theta-machines/DEV-G2-NANO/kicad/DEV-G2-NANO.kicad_pcb

## KiCad design kicad/DEV-G2-NANO.kicad_pcb (2026-06-29)

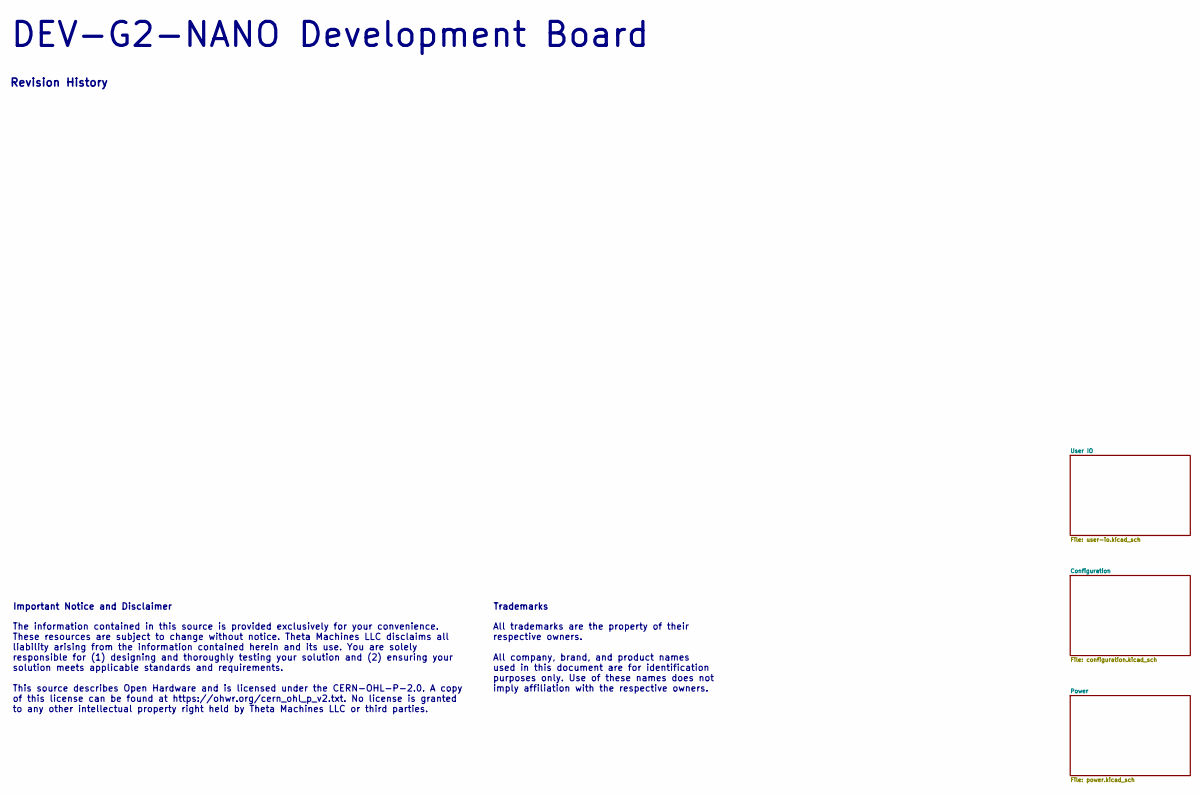
[picture p2: schematic DEV-G2-NANO.kicad_sch]

Notes on the sheet:
Revision History
DEV-G2-NANO Development Board
Important Notice and Disclaimer
Trademarks
The information contained in this source is provided exclusively for your convenience. These resources are subject to change without notice. Theta Machines LLC disclaims all liability arising from the information contained herein and its use. You are solely responsible for (1) designing and thoroug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
All trademarks are the property of their respective owners. All company, brand, and product names used in this document are for identification purposes only. Use of these names does not imply affiliation with the respective owners.

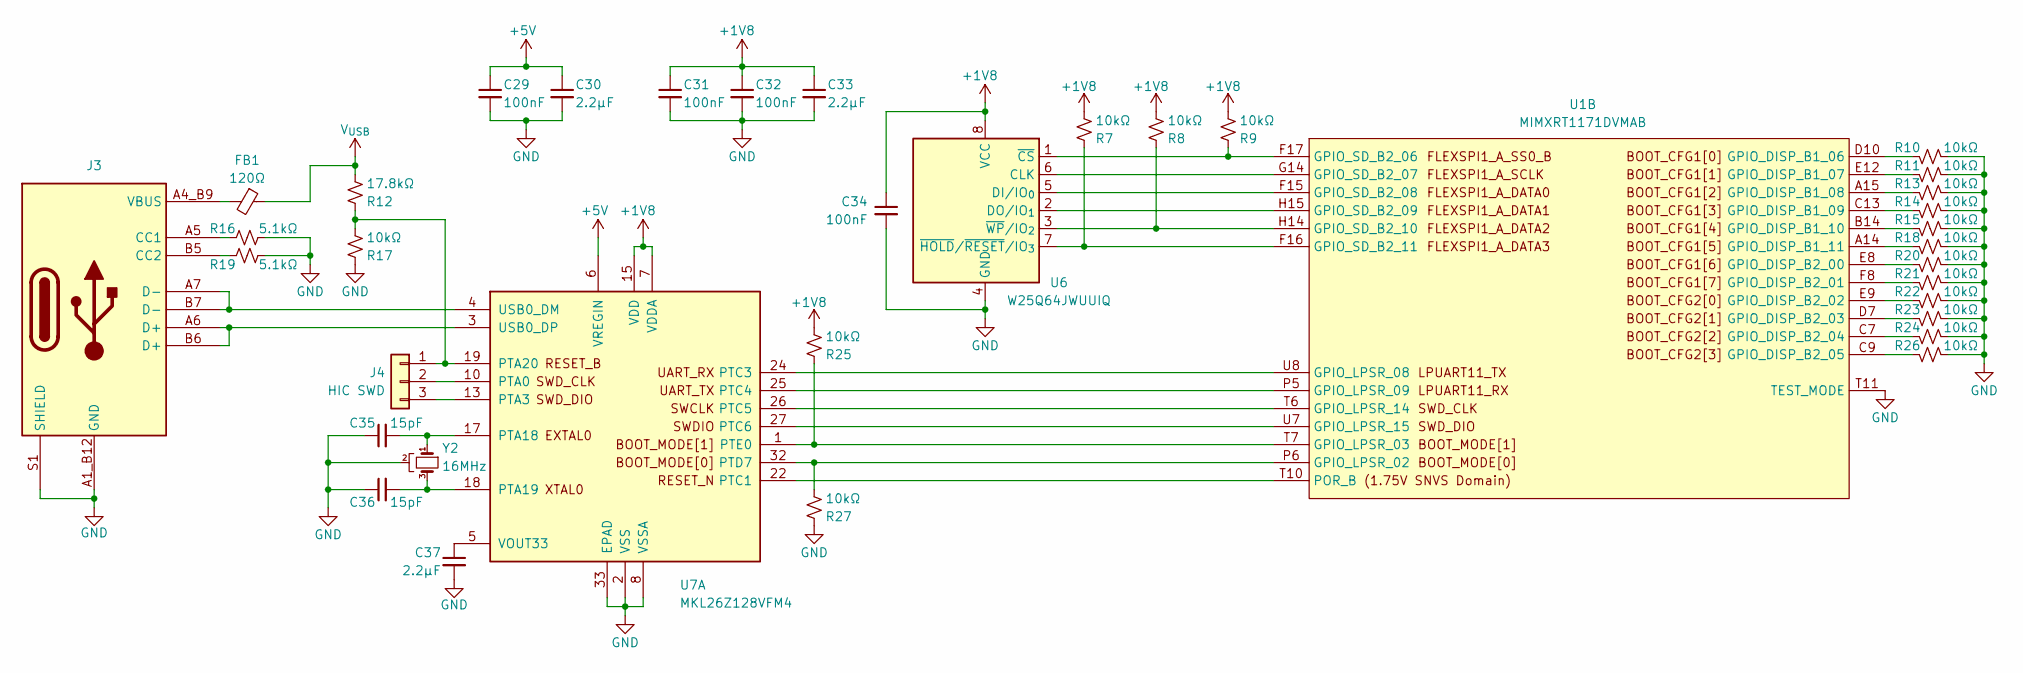
[picture p3: schematic configuration.kicad_sch, DEV-G2-NANO]

Parts:
C29, C31, C32, C34: 100nF; C_0201_0603Metric
C30, C33, C37: 2.2μF; C_0201_0603Metric
C35, C36: 15pF; C_0402_1005Metric
FB1: 120Ω; L_0402_1005Metric
J3: USB C; UJ20-C-H-G-SMT-5-P16
J4: HIC SWD; TestPoints-3
R7, R8, R9, R10, R11, R13, R14, R15, R17, R18, R20, R21, R22, R23, R24, R25, R26, R27: 10kΩ; R_0201_0603Metric
R12: 17.8kΩ; R_0201_0603Metric
R16, R19: 5.1kΩ; R_0201_0603Metric
U1: MIMXRT1171DVMAB
U6: W25Q64JWUUIQ
U7: MKL26Z128VFM4
Y2: 16MHz; Crystal-4-Pin

Connections:
+1V8: C31.1, C32.1, C33.1, C34.1, R7.2, R8.2, R9.2, R25.2, U6.8 (VCC), U7.7 (VDDA), U7.15 (VDD); also elsewhere on the board
+5V: C29.1, C30.1, U7.6 (VREGIN); also elsewhere on the board
GND: C29.2, C30.2, C31.2, C32.2, C33.2, C34.2, C35.1, C36.1, C37.2, J3.A1_B12 (GND), J3.B1_A12 (GND), J3.S1 (SHIELD), R10.2, R11.2, R13.2, R14.2, R15.2, R16.2, R17.1, R18.2, R19.2, R20.2, R21.2, R22.2, R23.2, R24.2, R26.2, R27.1, U1.T11 (TEST_MODE), U6.4 (GND), U7.2 (VSS), U7.8 (VSSA), U7.16 (VSS), U7.33 (EPAD), Y2.2 (GND), Y2.4 (GND); also elsewhere on the board
unnamed: FB1.2, J3.A4_B9 (VBUS), J3.B4_A9 (VBUS)
unnamed: J3.A5 (CC1), R16.1
unnamed: J3.B5 (CC2), R19.1
unnamed: J4.1, R12.1, R17.2, U7.19 (PTA20)
unnamed: J4.2, U7.10 (PTA0)
unnamed: J4.3, U7.13 (PTA3)
unnamed: R10.1, U1.D10 (GPIO_DISP_B1_06)
unnamed: R11.1, U1.E12 (GPIO_DISP_B1_07)
unnamed: R13.1, U1.A15 (GPIO_DISP_B1_08)
unnamed: R14.1, U1.C13 (GPIO_DISP_B1_09)
unnamed: R15.1, U1.B14 (GPIO_DISP_B1_10)
unnamed: R18.1, U1.A14 (GPIO_DISP_B1_11)
unnamed: R20.1, U1.E8 (GPIO_DISP_B2_00)
unnamed: R21.1, U1.F8 (GPIO_DISP_B2_01)
unnamed: R22.1, U1.E9 (GPIO_DISP_B2_02)
unnamed: R23.1, U1.D7 (GPIO_DISP_B2_03)
unnamed: R24.1, U1.C7 (GPIO_DISP_B2_04)
unnamed: R26.1, U1.C9 (GPIO_DISP_B2_05)
unnamed: R27.2, U1.P6 (GPIO_LPSR_02), U7.32 (PTD7)
unnamed: R25.1, U1.T7 (GPIO_LPSR_03), U7.1 (PTE0)
unnamed: U1.U8 (GPIO_LPSR_08), U7.24 (PTC3)
unnamed: U1.P5 (GPIO_LPSR_09), U7.25 (PTC4)
unnamed: U1.T6 (GPIO_LPSR_14), U7.26 (PTC5)
unnamed: U1.U7 (GPIO_LPSR_15), U7.27 (PTC6)
unnamed: R9.1, U1.F17 (GPIO_SD_B2_06), U6.1 (~CS)
unnamed: U1.G14 (GPIO_SD_B2_07), U6.6 (CLK)
unnamed: U1.F15 (GPIO_SD_B2_08), U6.5 (DI/IO_{0})
unnamed: U1.H15 (GPIO_SD_B2_09), U6.2 (DO/IO_{1})
unnamed: R8.1, U1.H14 (GPIO_SD_B2_10), U6.3 (~WP/IO_{2})
unnamed: R7.1, U1.F16 (GPIO_SD_B2_11), U6.7 (~HOLD/~RESET/IO_{3})
unnamed: U1.T10 (POR_B), U7.22 (PTC1)
unnamed: C35.2, U7.17 (PTA18), Y2.1
unnamed: C36.2, U7.18 (PTA19), Y2.3
unnamed: J3.A7 (D-), J3.B7 (D-), U7.4 (USB0_DM)
unnamed: J3.A6 (D+), J3.B6 (D+), U7.3 (USB0_DP)
unnamed: C37.1, U7.5 (VOUT33)
V_{USB}: FB1.1, R12.2; also elsewhere on the board

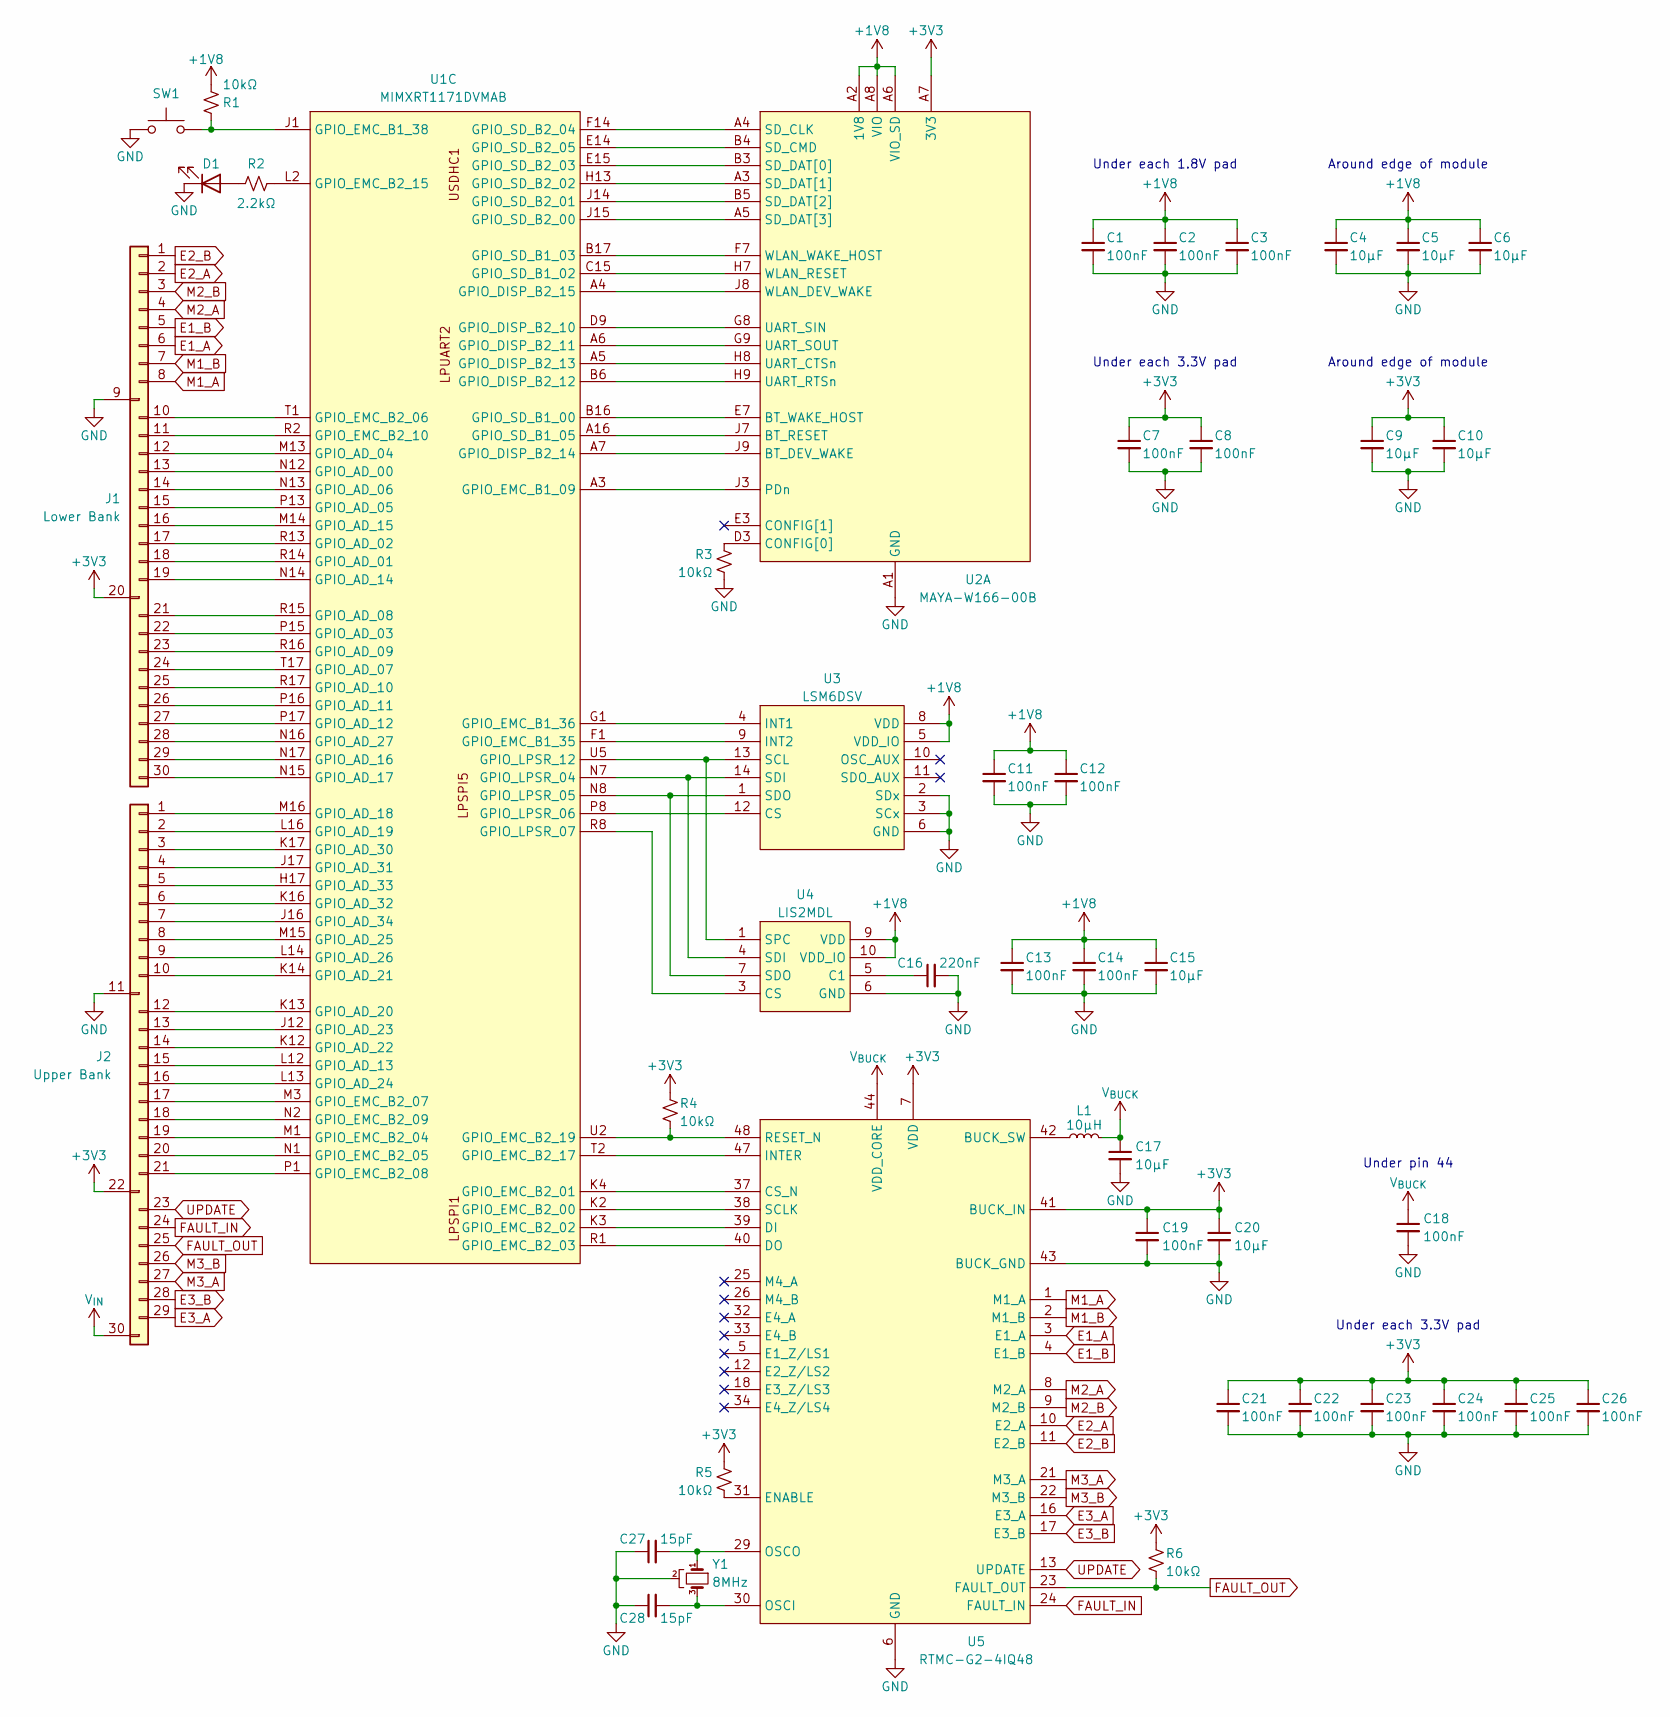
[picture p4: schematic user-io.kicad_sch, DEV-G2-NANO]

Parts:
C1, C2, C3, C7, C8, C11, C12, C13, C14, C18, C19, C21, C22, C23, C24, C25, C26: 100nF; C_0201_0603Metric
C4, C5, C6, C9, C10, C15, C17, C20: 10μF; C_0402_1005Metric
C16: 220nF; C_0201_0603Metric
C27, C28: 15pF; C_0402_1005Metric
D1: RED; LED_0603_1608Metric
J1: Lower Bank; Header-1x30
J2: Upper Bank; Header-1x30
L1: 10μH; L_1008_2520Metric
R1, R3, R4, R5, R6: 10kΩ; R_0201_0603Metric
R2: 2.2kΩ; R_0201_0603Metric
SW1: PTS815
U1: MIMXRT1171DVMAB
U2: MAYA-W166-00B
U3: LSM6DSV
U4: LIS2MDL
U5: RTMC-G2-4IQ48
Y1: 8MHz; Crystal-4-Pin

Connections:
+1V8: C1.1, C2.1, C3.1, C4.1, C5.1, C6.1, C11.1, C12.1, C13.1, C14.1, C15.1, R1.2, U2.A2 (1V8), U2.A6 (VIO_SD), U2.A8 (VIO), U3.5 (VDD_IO), U3.8 (VDD), U4.9 (VDD), U4.10 (VDD_IO); also elsewhere on the board
+3V3: C7.1, C8.1, C9.1, C10.1, C19.1, C20.1, C21.1, C22.1, C23.1, C24.1, C25.1, C26.1, J1.20, J2.22, R4.1, R5.1, R6.1, U2.A7 (3V3), U2.B7 (3V3), U5.7 (VDD), U5.15 (VDD), U5.20 (VDD), U5.28 (VDD), U5.36 (VDD), U5.41 (BUCK_IN), U5.46 (VDD); also elsewhere on the board
E1_A: J1.6, U5.3 (E1_A)
E1_B: J1.5, U5.4 (E1_B)
E2_A: J1.2, U5.10 (E2_A)
E2_B: J1.1, U5.11 (E2_B)
E3_A: J2.29, U5.16 (E3_A)
E3_B: J2.28, U5.17 (E3_B)
FAULT_IN: J2.24, U5.24 (FAULT_IN)
FAULT_OUT: J2.25, R6.2, U5.23 (FAULT_OUT)
GND: C1.2, C2.2, C3.2, C4.2, C5.2, C6.2, C7.2, C8.2, C9.2, C10.2, C11.2, C12.2, C13.2, C14.2, C15.2, C16.2, C17.2, C18.2, C19.2, C20.2, C21.2, C22.2, C23.2, C24.2, C25.2, C26.2, C27.1, C28.1, D1.1 (K), J1.9, J2.11, R3.2, SW1.1, U2.A1 (GND), U2.A9 (GND), U2.B2 (GND), U2.B8 (GND), U2.E4 (GND), U2.E5 (GND), U2.F4 (GND), U2.F5 (GND), U2.H4 (GND), U2.H5 (GND), U2.K2 (GND), U2.K3 (GND), U2.K4 (GND), U2.K6 (GND), U2.K7 (GND), U2.K8 (GND), U2.L1 (GND), U2.L9 (GND), U2.M1 (GND), U2.M2 (GND), U2.M8 (GND), U2.M9 (GND), U3.2 (SDx), U3.3 (SCx), U3.6 (GND), U3.7 (GND), U4.6 (GND), U4.8 (GND), U5.6 (GND), U5.14 (GND), U5.19 (GND), U5.27 (GND), U5.35 (GND), U5.43 (BUCK_GND), U5.45 (GND), Y1.2 (GND), Y1.4 (GND); also elsewhere on the board
M1_A: J1.8, U5.1 (M1_A)
M1_B: J1.7, U5.2 (M1_B)
M2_A: J1.4, U5.8 (M2_A)
M2_B: J1.3, U5.9 (M2_B)
M3_A: J2.27, U5.21 (M3_A)
M3_B: J2.26, U5.22 (M3_B)
unnamed: D1.2 (A), R2.1
unnamed: J1.10, U1.T1 (GPIO_EMC_B2_06)
unnamed: J1.11, U1.R2 (GPIO_EMC_B2_10)
unnamed: J1.12, U1.M13 (GPIO_AD_04)
unnamed: J1.13, U1.N12 (GPIO_AD_00)
unnamed: J1.14, U1.N13 (GPIO_AD_06)
unnamed: J1.15, U1.P13 (GPIO_AD_05)
unnamed: J1.16, U1.M14 (GPIO_AD_15)
unnamed: J1.17, U1.R13 (GPIO_AD_02)
unnamed: J1.18, U1.R14 (GPIO_AD_01)
unnamed: J1.19, U1.N14 (GPIO_AD_14)
unnamed: J1.21, U1.R15 (GPIO_AD_08)
unnamed: J1.22, U1.P15 (GPIO_AD_03)
unnamed: J1.23, U1.R16 (GPIO_AD_09)
unnamed: J1.24, U1.T17 (GPIO_AD_07)
unnamed: J1.25, U1.R17 (GPIO_AD_10)
unnamed: J1.26, U1.P16 (GPIO_AD_11)
unnamed: J1.27, U1.P17 (GPIO_AD_12)
unnamed: J1.28, U1.N16 (GPIO_AD_27)
unnamed: J1.29, U1.N17 (GPIO_AD_16)
unnamed: J1.30, U1.N15 (GPIO_AD_17)
unnamed: J2.1, U1.M16 (GPIO_AD_18)
unnamed: J2.2, U1.L16 (GPIO_AD_19)
unnamed: J2.3, U1.K17 (GPIO_AD_30)
unnamed: J2.4, U1.J17 (GPIO_AD_31)
unnamed: J2.5, U1.H17 (GPIO_AD_33)
unnamed: J2.6, U1.K16 (GPIO_AD_32)
unnamed: J2.7, U1.J16 (GPIO_AD_34)
unnamed: J2.8, U1.M15 (GPIO_AD_25)
unnamed: J2.9, U1.L14 (GPIO_AD_26)
unnamed: J2.10, U1.K14 (GPIO_AD_21)
unnamed: J2.12, U1.K13 (GPIO_AD_20)
unnamed: J2.13, U1.J12 (GPIO_AD_23)
unnamed: J2.14, U1.K12 (GPIO_AD_22)
unnamed: J2.15, U1.L12 (GPIO_AD_13)
unnamed: J2.16, U1.L13 (GPIO_AD_24)
unnamed: J2.17, U1.M3 (GPIO_EMC_B2_07)
unnamed: J2.18, U1.N2 (GPIO_EMC_B2_09)
unnamed: J2.19, U1.M1 (GPIO_EMC_B2_04)
unnamed: J2.20, U1.N1 (GPIO_EMC_B2_05)
unnamed: J2.21, U1.P1 (GPIO_EMC_B2_08)
unnamed: U1.D9 (GPIO_DISP_B2_10), U2.G8 (UART_SIN)
unnamed: U1.A6 (GPIO_DISP_B2_11), U2.G9 (UART_SOUT)
unnamed: U1.B6 (GPIO_DISP_B2_12), U2.H9 (UART_RTSn)
unnamed: U1.A5 (GPIO_DISP_B2_13), U2.H8 (UART_CTSn)
unnamed: U1.A7 (GPIO_DISP_B2_14), U2.J9 (BT_DEV_WAKE)
unnamed: U1.A4 (GPIO_DISP_B2_15), U2.J8 (WLAN_DEV_WAKE)
unnamed: U1.A3 (GPIO_EMC_B1_09), U2.J3 (PDn)
unnamed: U1.F1 (GPIO_EMC_B1_35), U3.9 (INT2)
unnamed: U1.G1 (GPIO_EMC_B1_36), U3.4 (INT1)
unnamed: R1.1, SW1.2, U1.J1 (GPIO_EMC_B1_38)
unnamed: U1.K2 (GPIO_EMC_B2_00), U5.38 (SCLK)
unnamed: U1.K4 (GPIO_EMC_B2_01), U5.37 (CS_N)
unnamed: U1.K3 (GPIO_EMC_B2_02), U5.39 (DI)
unnamed: U1.R1 (GPIO_EMC_B2_03), U5.40 (DO)
unnamed: R2.2, U1.L2 (GPIO_EMC_B2_15)
unnamed: U1.T2 (GPIO_EMC_B2_17), U5.47 (INTER)
unnamed: R4.2, U1.U2 (GPIO_EMC_B2_19), U5.48 (RESET_N)
unnamed: U1.N7 (GPIO_LPSR_04), U3.14 (SDI), U4.4 (SDI)
unnamed: U1.N8 (GPIO_LPSR_05), U3.1 (SDO), U4.7 (SDO)
unnamed: U1.P8 (GPIO_LPSR_06), U3.12 (CS)
unnamed: U1.R8 (GPIO_LPSR_07), U4.3 (CS)
unnamed: U1.U5 (GPIO_LPSR_12), U3.13 (SCL), U4.1 (SPC)
unnamed: U1.B16 (GPIO_SD_B1_00), U2.E7 (BT_WAKE_HOST)
unnamed: U1.C15 (GPIO_SD_B1_02), U2.H7 (WLAN_RESET)
unnamed: U1.B17 (GPIO_SD_B1_03), U2.F7 (WLAN_WAKE_HOST)
unnamed: U1.A16 (GPIO_SD_B1_05), U2.J7 (BT_RESET)
unnamed: U1.J15 (GPIO_SD_B2_00), U2.A5 (SD_DAT[3])
unnamed: U1.J14 (GPIO_SD_B2_01), U2.B5 (SD_DAT[2])
unnamed: U1.H13 (GPIO_SD_B2_02), U2.A3 (SD_DAT[1])
unnamed: U1.E15 (GPIO_SD_B2_03), U2.B3 (SD_DAT[0])
unnamed: U1.F14 (GPIO_SD_B2_04), U2.A4 (SD_CLK)
unnamed: U1.E14 (GPIO_SD_B2_05), U2.B4 (SD_CMD)
unnamed: R3.1, U2.D3 (CONFIG[0])
unnamed: C16.1, U4.5 (C1)
unnamed: L1.2, U5.42 (BUCK_SW)
unnamed: R5.2, U5.31 (ENABLE)
unnamed: C28.2, U5.30 (OSCI), Y1.3
unnamed: C27.2, U5.29 (OSCO), Y1.1
UPDATE: J2.23, U5.13 (UPDATE)
V_{BUCK}: C17.1, C18.1, L1.1, U5.44 (VDD_CORE)
V_{IN}: J2.30; also elsewhere on the board

Notes on the sheet:
Under each 1.8V pad
Around edge of module
Under each 3.3V pad
Under pin 44

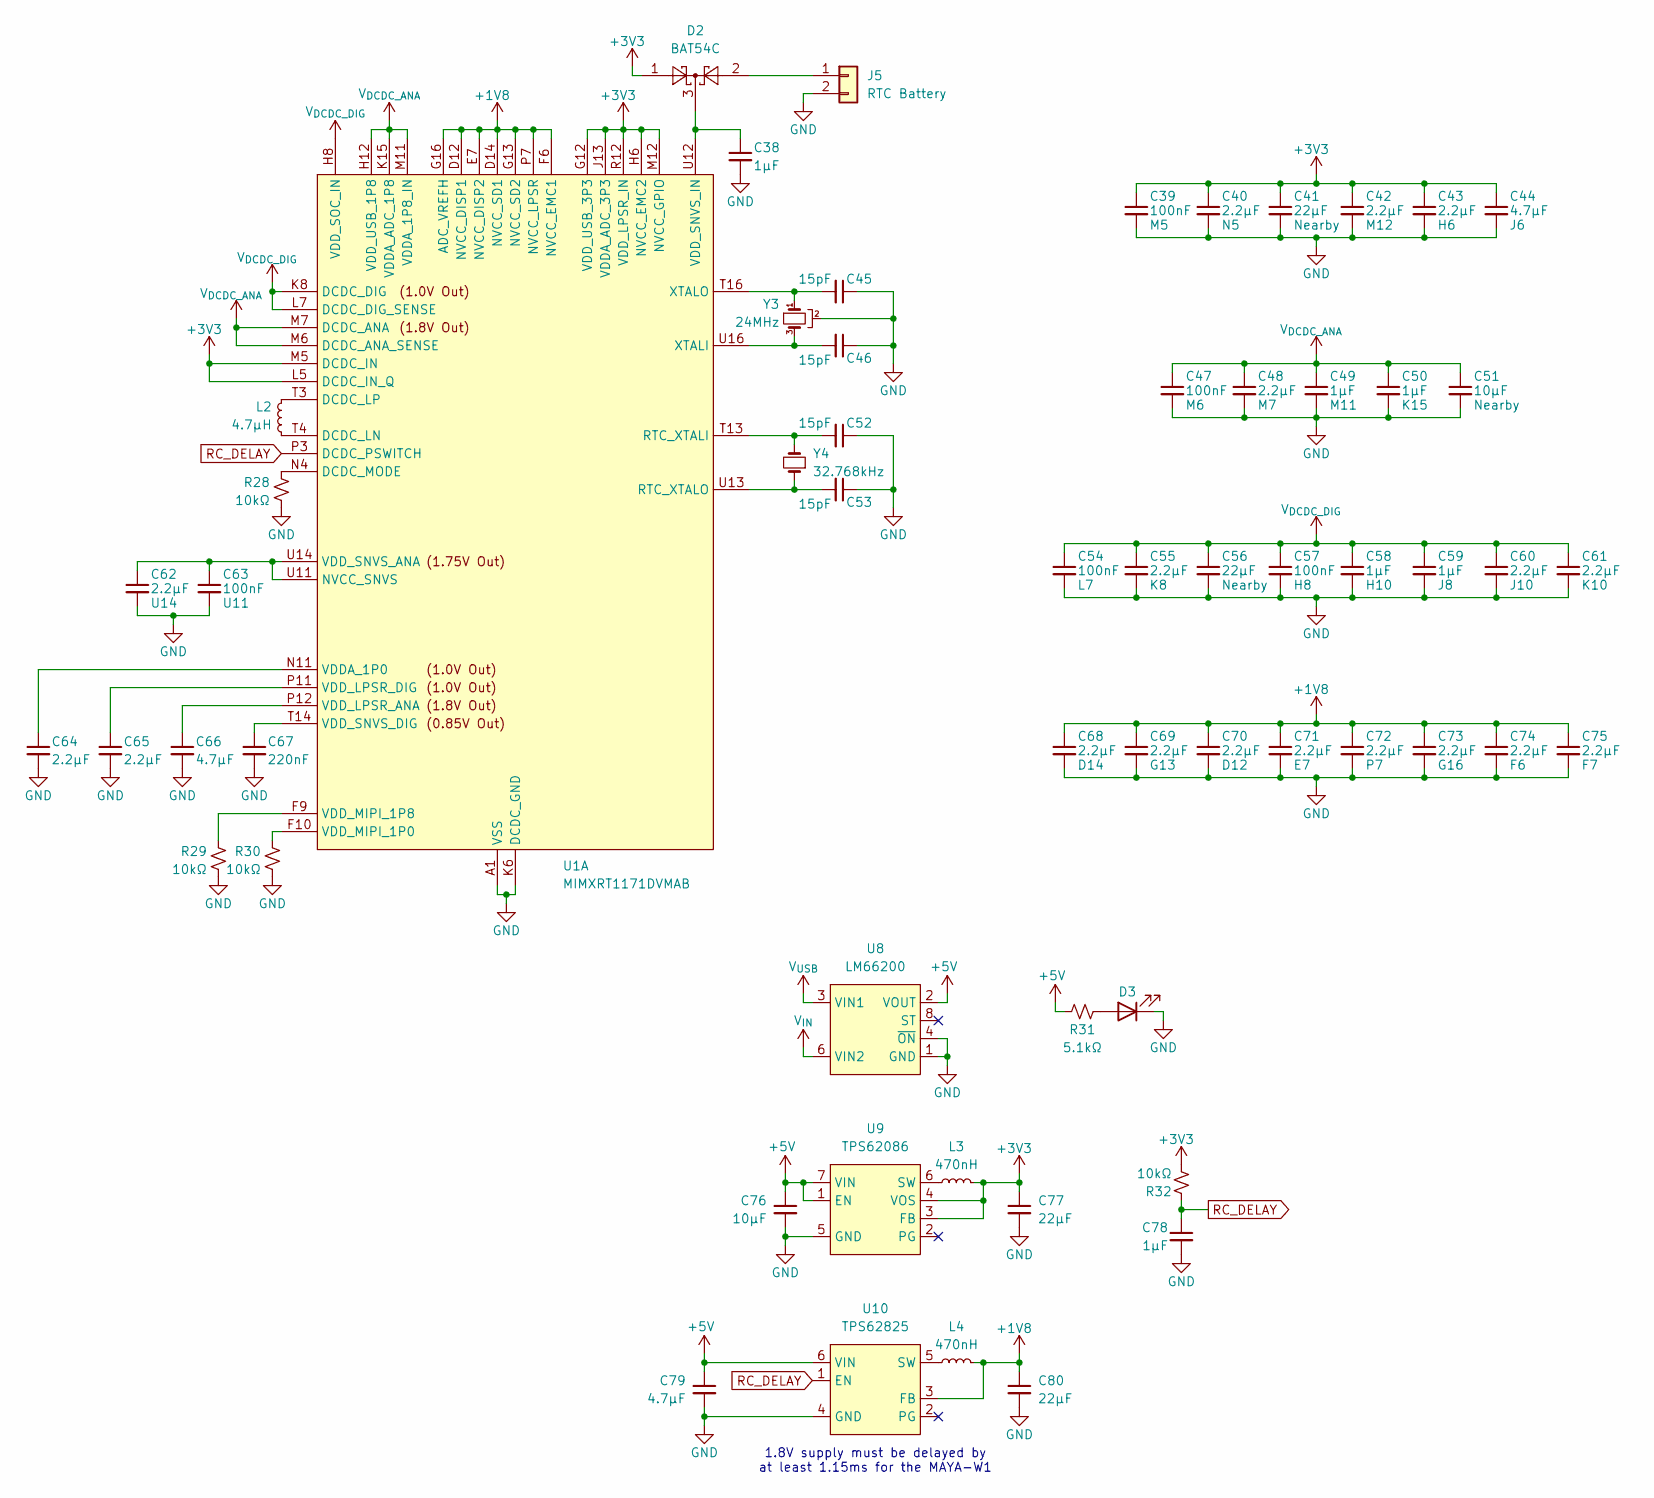
[picture p5: schematic power.kicad_sch, DEV-G2-NANO]

Parts:
C38, C49, C50, C58, C59, C78: 1μF; C_0201_0603Metric
C39, C47, C54, C57, C63: 100nF; C_0201_0603Metric
C40, C42, C43, C48, C55, C60, C61, C62, C64, C65, C68, C69, C70, C71, C72, C73, C74, C75: 2.2μF; C_0201_0603Metric
C41, C56, C77, C80: 22μF; C_0603_1608Metric
C44, C66, C79: 4.7μF; C_0402_1005Metric
C45, C46, C52, C53: 15pF; C_0402_1005Metric
C51, C76: 10μF; C_0402_1005Metric
C67: 220nF; C_0201_0603Metric
D2: BAT54C
D3: RED; LED_0603_1608Metric
J5: RTC Battery; Header-1x02
L2: 4.7μH; SDCL1V4018
L3, L4: 470nH; L_0806
R28, R29, R30, R32: 10kΩ; R_0201_0603Metric
R31: 5.1kΩ; R_0201_0603Metric
U1: MIMXRT1171DVMAB
U8: LM66200
U9: TPS62086
U10: TPS62825
Y3: 24MHz; Crystal-4-Pin
Y4: 32.768kHz; Crystal-2-Pin

Connections:
+1V8: C68.1, C69.1, C70.1, C71.1, C72.1, C73.1, C74.1, C75.1, C80.1, L4.2, U1.D12 (NVCC_DISP1), U1.D14 (NVCC_SD1), U1.E7 (NVCC_DISP2), U1.F6 (NVCC_EMC1), U1.F7 (NVCC_EMC1), U1.G6 (NVCC_EMC1), U1.G13 (NVCC_SD2), U1.G16 (ADC_VREFH), U1.P7 (NVCC_LPSR), U10.3 (FB); also elsewhere on the board
+3V3: C39.1, C40.1, C41.1, C42.1, C43.1, C44.1, C77.1, D2.1, L3.2, R32.2, U1.G12 (VDD_USB_3P3), U1.H6 (NVCC_EMC2), U1.J6 (NVCC_EMC2), U1.J13 (VDDA_ADC_3P3), U1.L5 (DCDC_IN_Q), U1.M5 (DCDC_IN), U1.M12 (NVCC_GPIO), U1.N5 (DCDC_IN), U1.R12 (VDD_LPSR_IN), U9.3 (FB), U9.4 (VOS); also elsewhere on the board
+5V: C76.1, C79.1, R31.1, U8.2 (VOUT), U8.7 (VOUT), U9.1 (EN), U9.7 (VIN), U10.6 (VIN); also elsewhere on the board
GND: C38.2, C39.2, C40.2, C41.2, C42.2, C43.2, C44.2, C45.1, C46.1, C47.2, C48.2, C49.2, C50.2, C51.2, C52.1, C53.1, C54.2, C55.2, C56.2, C57.2, C58.2, C59.2, C60.2, C61.2, C62.2, C63.2, C64.2, C65.2, C66.2, C67.2, C68.2, C69.2, C70.2, C71.2, C72.2, C73.2, C74.2, C75.2, C76.2, C77.2, C78.2, C79.2, C80.2, D3.1 (K), J5.2, R28.2, R29.2, R30.2, U1.A1 (VSS), U1.A17 (VSS), U1.B7 (VSS), U1.C8 (VSS), U1.C10 (VSS), U1.C12 (VSS), U1.C14 (VSS), U1.D4 (VSS), U1.F11 (VSS), U1.F12 (VSS), U1.F13 (VSS), U1.G3 (VSS), U1.G7 (VSS), U1.G8 (VSS), U1.G9 (VSS), U1.G10 (VSS), U1.G11 (VSS), U1.G15 (VSS), U1.H7 (VSS), U1.H11 (VSS), U1.J7 (VSS), U1.J11 (VSS), U1.K6 (DCDC_GND), U1.K7 (DCDC_GND), U1.K11 (VSS), U1.L3 (VSS), U1.L6 (DCDC_GND), U1.L10 (VSS), U1.L11 (VSS), U1.L15 (VSS), U1.P4 (VSS), U1.P14 (VSS), U1.R4 (VSS), U1.R7 (VSS), U1.T12 (VSS), U1.U1 (VSS), U1.U17 (VSS), U8.1 (GND), U8.4 (~ON), U8.5 (GND), U9.5 (GND), U10.4 (GND), Y3.2 (GND), Y3.4 (GND); also elsewhere on the board
unnamed: D3.2 (A), R31.2
unnamed: D2.2, J5.1
unnamed: L2.1, U1.T4 (DCDC_LN), U1.U4 (DCDC_LN)
unnamed: L2.2, U1.T3 (DCDC_LP), U1.U3 (DCDC_LP)
unnamed: R28.1, U1.N4 (DCDC_MODE)
unnamed: C62.1, C63.1, U1.U11 (NVCC_SNVS), U1.U14 (VDD_SNVS_ANA)
unnamed: C52.2, U1.T13 (RTC_XTALI), Y4.2
unnamed: C53.2, U1.U13 (RTC_XTALO), Y4.1
unnamed: C64.1, U1.N11 (VDDA_1P0)
unnamed: C66.1, U1.P12 (VDD_LPSR_ANA)
unnamed: C65.1, U1.P11 (VDD_LPSR_DIG)
unnamed: R30.1, U1.F10 (VDD_MIPI_1P0)
unnamed: R29.1, U1.F9 (VDD_MIPI_1P8)
unnamed: C67.1, U1.T14 (VDD_SNVS_DIG)
unnamed: C38.1, D2.3, U1.U12 (VDD_SNVS_IN)
unnamed: C46.2, U1.U16 (XTALI), Y3.3
unnamed: C45.2, U1.T16 (XTALO), Y3.1
unnamed: L3.1, U9.6 (SW)
unnamed: L4.1, U10.5 (SW)
RC_DELAY: C78.1, R32.1, U1.P3 (DCDC_PSWITCH), U10.1 (EN)
V_{DCDC_ANA}: C47.1, C48.1, C49.1, C50.1, C51.1, U1.H12 (VDD_USB_1P8), U1.K15 (VDDA_ADC_1P8), U1.M6 (DCDC_ANA_SENSE), U1.M7 (DCDC_ANA), U1.M8 (DCDC_ANA), U1.M11 (VDDA_1P8_IN)
V_{DCDC_DIG}: C54.1, C55.1, C56.1, C57.1, C58.1, C59.1, C60.1, C61.1, U1.H8 (VDD_SOC_IN), U1.H9 (VDD_SOC_IN), U1.H10 (VDD_SOC_IN), U1.J8 (VDD_SOC_IN), U1.J9 (VDD_SOC_IN), U1.J10 (VDD_SOC_IN), U1.K8 (DCDC_DIG), U1.K9 (DCDC_DIG), U1.K10 (VDD_SOC_IN), U1.L7 (DCDC_DIG_SENSE), U1.L8 (DCDC_DIG)
V_{IN}: U8.6 (VIN2); also elsewhere on the board
V_{USB}: U8.3 (VIN1); also elsewhere on the board

Notes on the sheet:
1.8V supply must be delayed by at least 1.15ms for the MAYA-W1

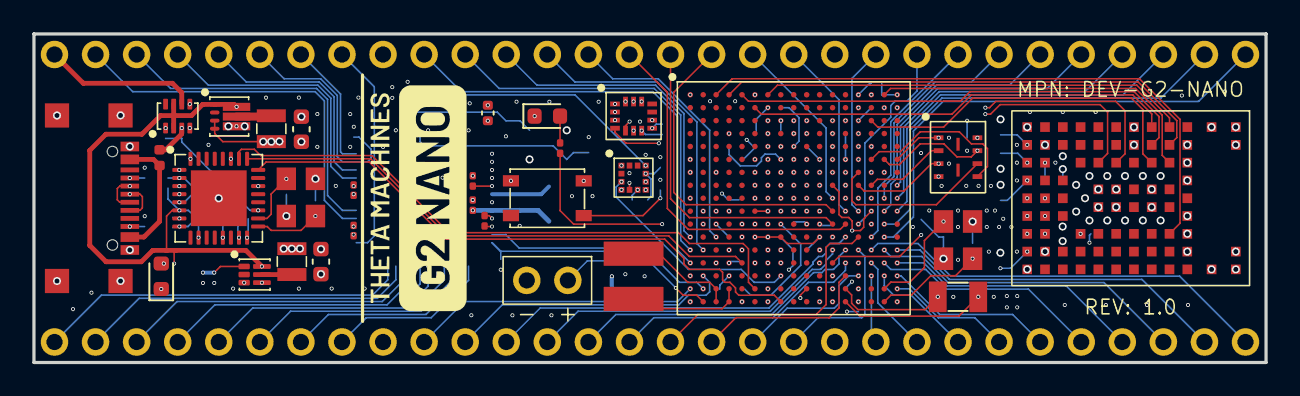
[picture p6: board DEV-G2-NANO.kicad_pcb from above]

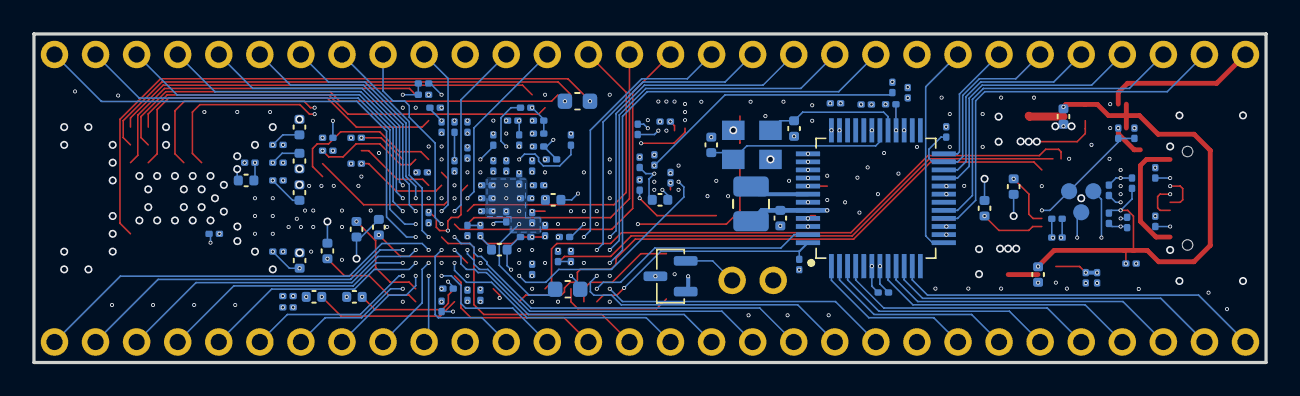
[picture p7: board DEV-G2-NANO.kicad_pcb from below]

Board: 6 copper layers, 76.2 x 20.3 mm, 140 parts (110 on the bottom side), 159 nets.
