theta-machines/DEV-G2-NANO/(commit log)

2026-04-18 created KiCad project
    [DEV-G2-NANO.kicad_pcb, DEV-G2-NANO.kicad_sch]
2026-04-19 added MIMXRT1171DVMAB symbol to project
    [DEV-G2-NANO.kicad_sch, disclaimer.kicad_sch]
2026-04-20 added boot config and flash chip
    [DEV-G2-NANO.kicad_sch]
2026-04-20 broke up MIMXRT1171DVMAB into several units
    [DEV-G2-NANO.kicad_sch]
2026-04-20 organized schematic into several sheets
    [DEV-G2-NANO.kicad_sch, configuration.kicad_sch, disclaimer.kicad_sch, power.kicad_sch, user-io.kicad_sch]
2026-04-24 added MAYA-W166-00B symbol
    [user-io.kicad_sch]
2026-04-25 reworked design to use 1.8V logic
    [configuration.kicad_sch, power.kicad_sch, user-io.kicad_sch]
2026-04-25 created footprint for Wi-Fi module (MAYA-W166)
    [MAYA-W166.step]
2026-04-26 documented SDIO pull resistors
2026-04-26 added user button and LED
    [DEV-G2-NANO.kicad_pcb, configuration.kicad_sch, power.kicad_sch, user-io.kicad_sch]
2026-04-26 added 3.3V and 1.8V buck converters to schematic
    [configuration.kicad_sch, power.kicad_sch]
2026-04-26 added IMU to schematic
    [power.kicad_sch, user-io.kicad_sch]
2026-04-26 added magnetometer to schematic
    [configuration.kicad_sch, power.kicad_sch, user-io.kicad_sch]
2026-04-26 added bypass caps
    [configuration.kicad_sch, power.kicad_sch, user-io.kicad_sch]
2026-04-27 added KL26 (DAPLink HIC) to schematic
    [configuration.kicad_sch, power.kicad_sch, user-io.kicad_sch]
2026-04-29 added RTMC-G2-4IQ48 to schematic
    [configuration.kicad_sch, power.kicad_sch, user-io.kicad_sch]
2026-04-29 added several footprints
    [DEV-G2-NANO.kicad_pcb, configuration.kicad_sch, power.kicad_sch, user-io.kicad_sch]
2026-04-30 added RTC battery connector
    [configuration.kicad_sch, power.kicad_sch, user-io.kicad_sch]
2026-04-30 centered TestPoints-3 footprint
2026-04-30 added crystal footprints
    [configuration.kicad_sch, power.kicad_sch, user-io.kicad_sch]
2026-04-30 added inductor footprints
    [power.kicad_sch, user-io.kicad_sch]
2026-04-30 reworked bypass capacitors for MIMXRT1171DVMAB
    [configuration.kicad_sch, power.kicad_sch, user-io.kicad_sch]
2026-04-30 moved ADC_VREFH to +1V8 rail
    [power.kicad_sch]
2026-05-01 added ferrite beads to VDD_USB_xxx pins
    [power.kicad_sch]
2026-05-01 reworked USB circuitry
    [configuration.kicad_sch, power.kicad_sch, user-io.kicad_sch]
2026-05-02 added remaining footprints
    [configuration.kicad_sch, power.kicad_sch, user-io.kicad_sch]
2026-05-02 finished preliminary layout
    [DEV-G2-NANO.kicad_pcb]
2026-05-02 removed USB host and 1.8V DAC
    [DEV-G2-NANO.kicad_pcb, configuration.kicad_sch, power.kicad_sch, user-io.kicad_sch]
2026-05-02 set PCB design rules
    [DEV-G2-NANO.kicad_pcb]
2026-05-04 updated footprints
2026-05-06 finished preliminary routing
    [DEV-G2-NANO.kicad_pcb, configuration.kicad_sch, power.kicad_sch, user-io.kicad_sch]
2026-05-06 added stitching vias and made cosmetic changes
    [DEV-G2-NANO.kicad_pcb, configuration.kicad_sch]
2026-05-07 removed 3D models from project_lib
    [DEV-G2-NANO.kicad_pcb, MAYA-W166.step]
2026-05-07 added solder paste to footprint
    [DEV-G2-NANO.kicad_pcb]
2026-05-12 added pull-up resistors to W25Q QSPI line
    [DEV-G2-NANO.kicad_pcb, configuration.kicad_sch, power.kicad_sch]
2026-06-29 cosmetic changes
    [DEV-G2-NANO.kicad_pcb]
