theta-machines/DEV-G2-NANO/(notices)

Notices in the files:
kicad/DEV-G2-NANO.kicad_sch:
© 2026, Theta Machines LLC.
This source describes Open Hardware and is licensed under the CERN-OHL-P-2.0. A copy of this license can be found at https://ohwr.org/cern_ohl_p_v2.txt. No license is granted to any other intellectual property right held by Theta Machines LLC or third parties.
